xnvi/full-color-led-display-unit-board/hardware/3D预览.png

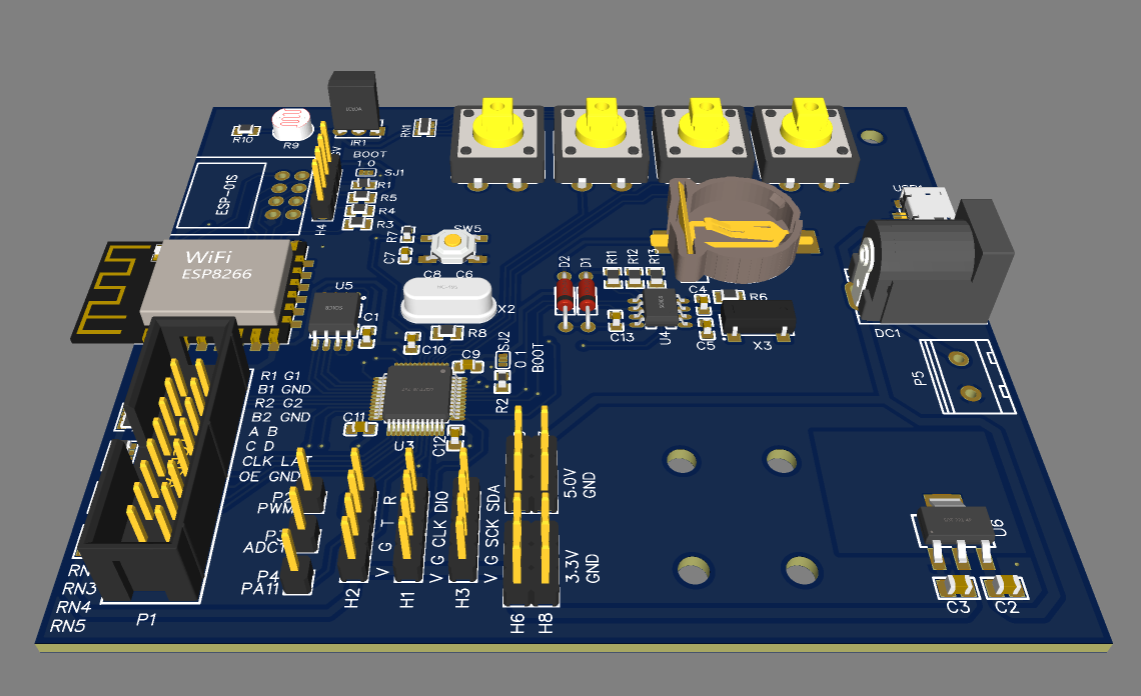
hardware/3D预览.png
