xnvi/full-color-led-display-unit-board/hardware/布线.png

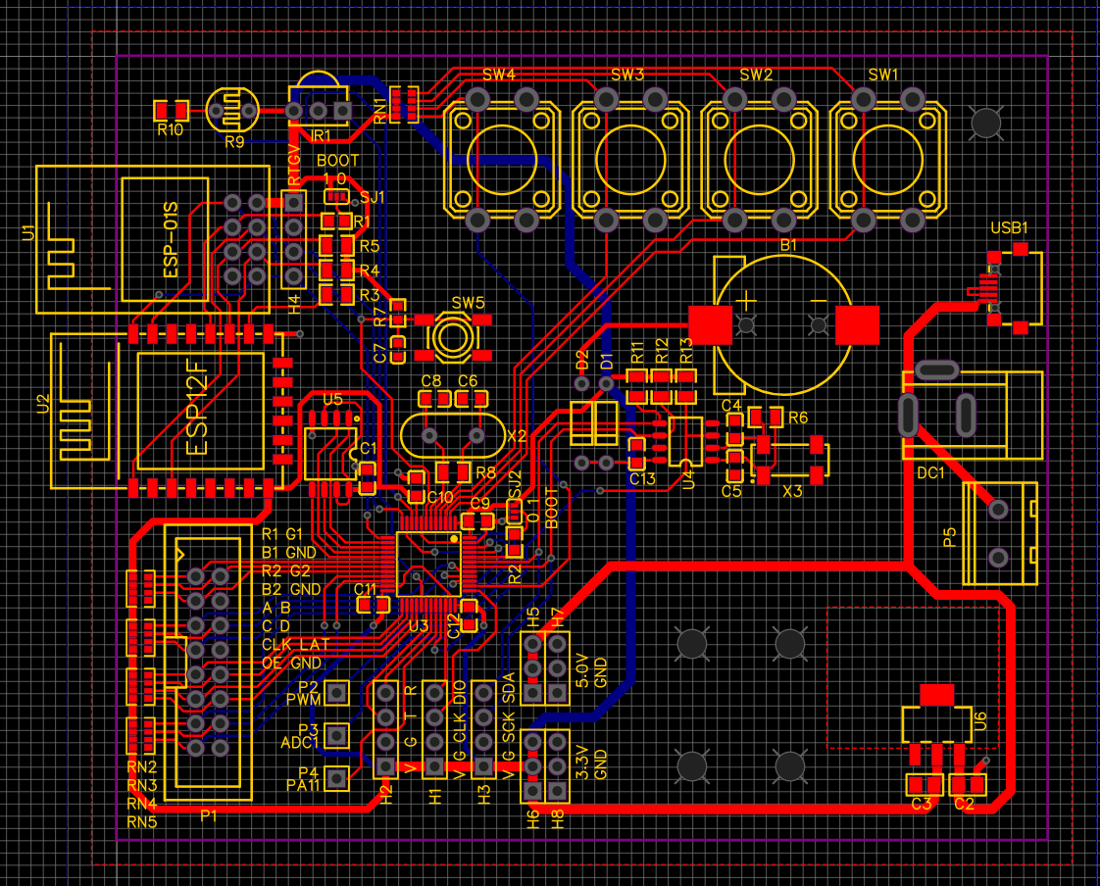
hardware/布线.png
