xnvi/full-color-led-display-unit-board/hardware/底面.png

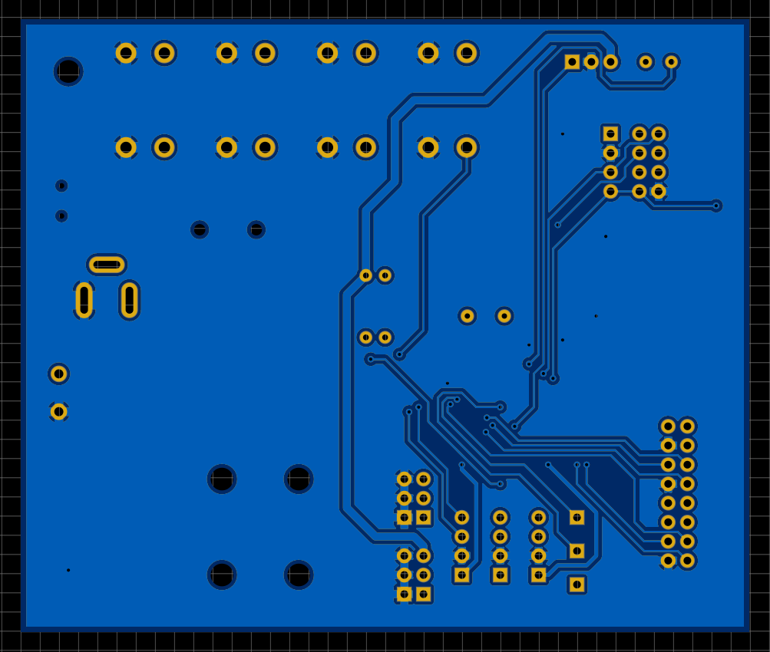
hardware/底面.png
