xnvi/full-color-led-display-unit-board/hardware/顶面.png

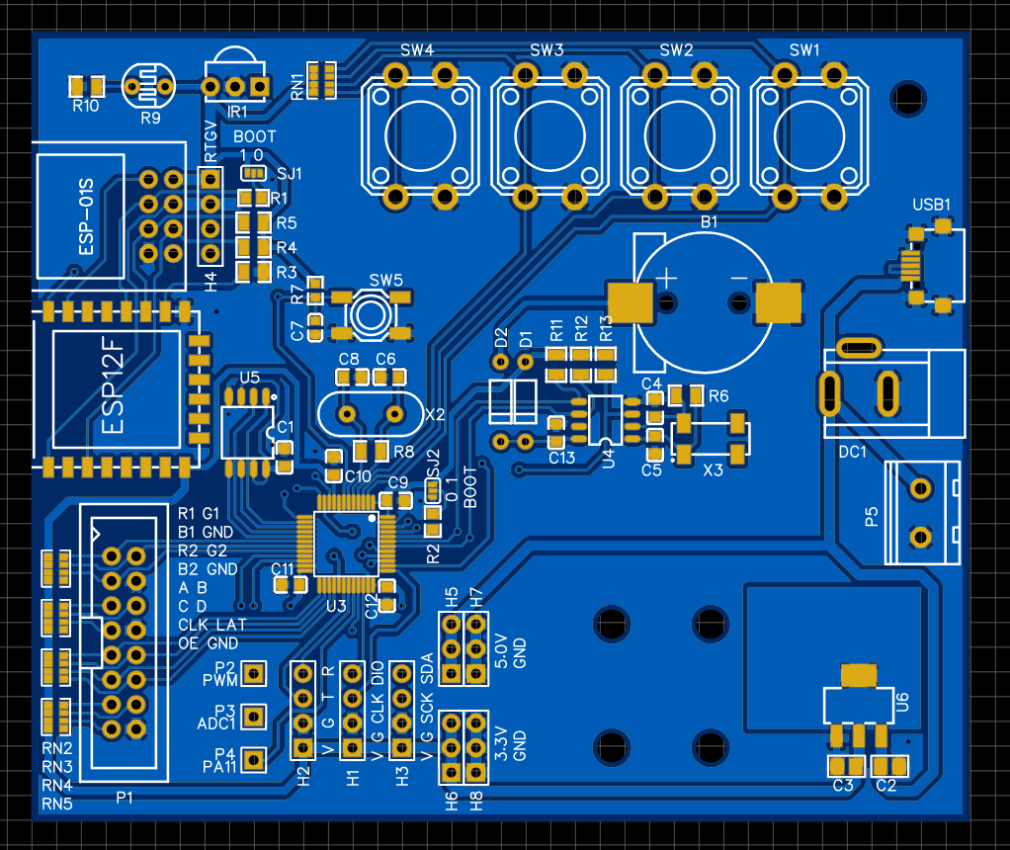
hardware/顶面.png
