xnvi/full-color-led-display-unit-board/hardware/Schematic.pdf

## F103RX与F401RX、F411RX等完全兼容

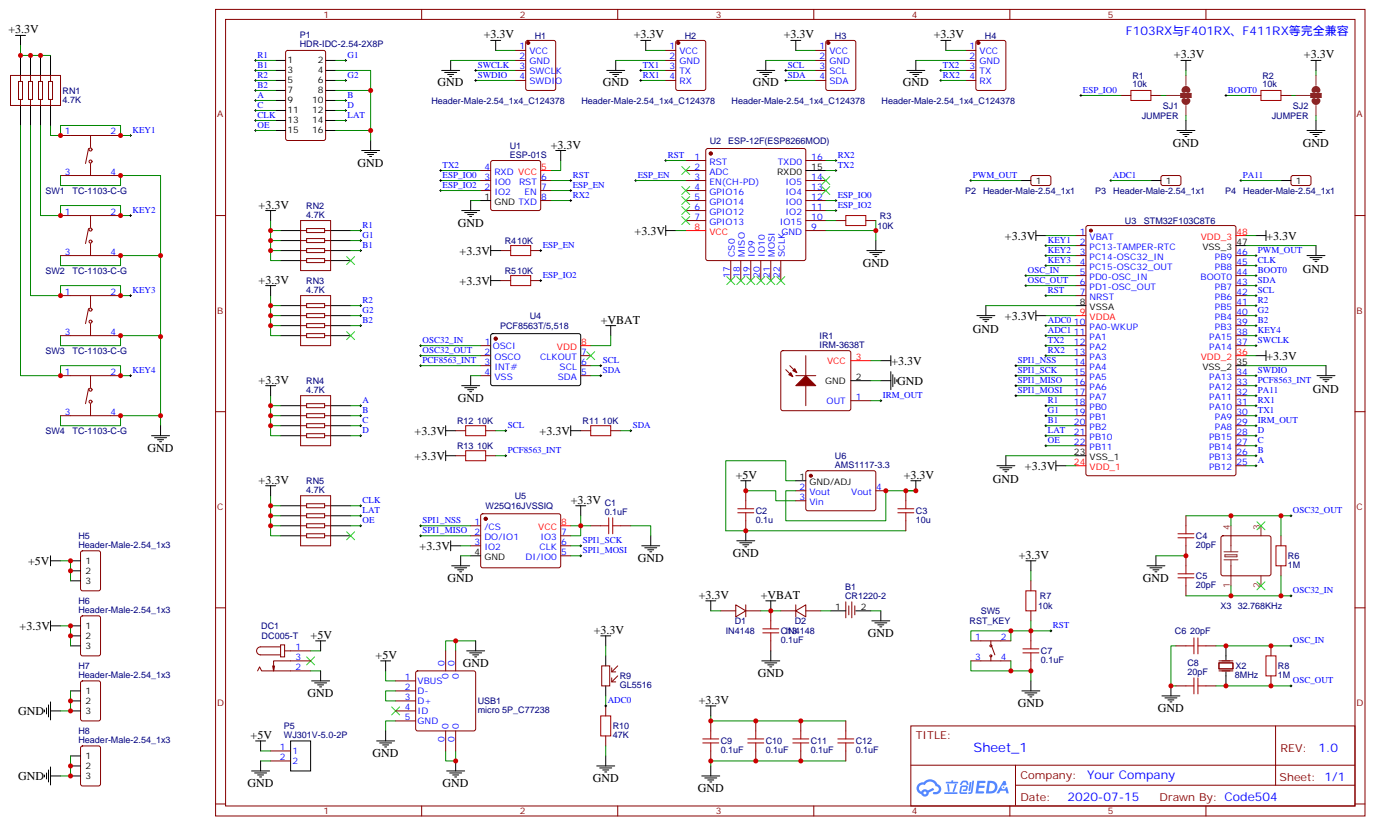
[picture p8: page 1]
