xnvi/full-color-led-display-unit-board/software/ext_lib/USMART/usmart_str.c

#include "usmart_str.h"
#include "usmart.h"		   
//////////////////////////////////////////////////////////////////////////////////	 
//本程序只供学习使用，未经作者许可，不得用于其它任何用途
//ALIENTEK STM32开发板	   
//正点原子@ALIENTEK
//技术论坛:www.openedv.com 
//版本：V3.3
//版权所有，盗版必究。
//Copyright(C) 正点原子 2011-2021
//All rights reserved
//********************************************************************************
//升级说明
//V1.4
//增加了对参数为string类型的函数的支持.适用范围大大提高.
//优化了内存占用,静态内存占用为79个字节@10个参数.动态适应数字及字符串长度
//V2.0 
//1,修改了list指令,打印函数的完整表达式.
//2,增加了id指令,打印每个函数的入口地址.
//3,修改了参数匹配,支持函数参数的调用(输入入口地址).
//4,增加了函数名长度宏定义.	
//V2.1 20110707		 
//1,增加dec,hex两个指令,用于设置参数显示进制,及执行进制转换.
//注:当dec,hex不带参数的时候,即设定显示参数进制.当后跟参数的时候,即执行进制转换.
//如:"dec 0XFF" 则会将0XFF转为255,由串口返回.
//如:"hex 100" 	则会将100转为0X64,由串口返回
//2,新增usmart_get_cmdname函数,用于获取指令名字.
//V2.2 20110726	
//1,修正了void类型参数的参数统计错误.
//2,修改数据显示格式默认为16进制.
//V2.3 20110815
//1,去掉了函数名后必须跟"("的限制.
//2,修正了字符串参数中不能有"("的bug.
//3,修改了函数默认显示参数格式的修改方式. 
//V2.4 20110905
//1,修改了usmart_get_cmdname函数,增加最大参数长度限制.避免了输入错误参数时的死机现象.
//2,增加USMART_ENTIM2_SCAN宏定义,用于配置是否使用TIM2定时执行scan函数.
//V2.5 20110930
//1,修改usmart_init函数为void usmart_init(u8 sysclk),可以根据系统频率自动设定扫描时间.(固定100ms)
//2,去掉了usmart_init函数中的uart_init函数,串口初始化必须在外部初始化,方便用户自行管理.
//V2.6 20111009
//1,增加了read_addr和write_addr两个函数.可以利用这两个函数读写内部任意地址(必须是有效地址).更加方便调试.
//2,read_addr和write_addr两个函数可以通过设置USMART_USE_WRFUNS为来使能和关闭.
//3,修改了usmart_strcmp,使其规范化.			  
//V2.7 20111024
//1,修正了返回值16进制显示时不换行的bug.
//2,增加了函数是否有返回值的判断,如果没有返回值,则不会显示.有返回值时才显示其返回值.
//V2.8 20111116
//1,修正了list等不带参数的指令发送后可能导致死机的bug.
//V2.9 20120917
//1,修改了形如：void*xxx(void)类型函数不能识别的bug。
//V3.0 20130425
//1,新增了字符串参数对转义符的支持。
//V3.1 20131120
//1,增加runtime系统指令,可以用于统计函数执行时间.
//用法:
//发送:runtime 1 ,则开启函数执行时间统计功能
//发送:runtime 0 ,则关闭函数执行时间统计功能
///runtime统计功能,必须设置:USMART_ENTIMX_SCAN 为1,才可以使用!!
//V3.2 20140828
//1,修改usmart_get_aparm函数,加入+/-符号的支持
//2,修改usmart_str2num函数,支持负数转换
//V3.3 20160506
//修正usmart_exe函数在USMART_ENTIMX_SCAN为0的时候，报错的bug
/////////////////////////////////////////////////////////////////////////////////////
  
//对比字符串str1和str2
//*str1:字符串1指针
//*str2:字符串2指针
//返回值:0，相等;1，不相等;
u8 usmart_strcmp(u8 *str1,u8 *str2)
{
	while(1)
	{
		if(*str1!=*str2)return 1;//不相等
		if(*str1=='\0')break;//对比完成了.
		str1++;
		str2++;
	}
	return 0;//两个字符串相等
}
//把str1的内容copy到str2
//*str1:字符串1指针
//*str2:字符串2指针			   
void usmart_strcopy(u8*str1,u8 *str2)
{
	while(1)
	{										   
		*str2=*str1;	//拷贝
		if(*str1=='\0')break;//拷贝完成了.
		str1++;
		str2++;
	}
}
//得到字符串的长度(字节)
//*str:字符串指针
//返回值:字符串的长度		   
u8 usmart_strlen(u8*str)
{
	u8 len=0;
	while(1)
	{							 
		if(*str=='\0')break;//拷贝完成了.
		len++;
		str++;
	}
	return len;
}
//m^n函数
//返回值:m^n次方
u32 usmart_pow(u8 m,u8 n)
{
	u32 result=1;	 
	while(n--)result*=m;    
	return result;
}	    
//把字符串转为数字
//支持16进制转换,但是16进制字母必须是大写的,且格式为以0X开头的.
//支持负数 
//*str:数字字符串指针
//*res:转换完的结果存放地址.
//返回值:0，成功转换完成.其他,错误代码.
//1,数据格式错误.2,16进制位数为0.3,起始格式错误.4,十进制位数为0.
u8 usmart_str2num(u8*str,u32 *res)
{
	u32 t;
	int tnum;
	u8 bnum=0;		//数字的位数
	u8 *p;		  
	u8 hexdec=10;	//默认为十进制数据
	u8 flag=0;		//0,没有符号标记;1,表示正数;2,表示负数.
	p=str;
	*res=0;//清零.
	while(1)
	{
		if((*p<='9'&&*p>='0')||((*str=='-'||*str=='+')&&bnum==0)||(*p<='F'&&*p>='A')||(*p=='X'&&bnum==1))//参数合法
		{
			if(*p>='A')hexdec=16;	//字符串中存在字母,为16进制格式.
			if(*str=='-'){flag=2;str+=1;}//偏移掉符号
			else if(*str=='+'){flag=1;str+=1;}//偏移掉符号
			else bnum++;			//位数增加.
		}else if(*p=='\0')break;	//碰到结束符,退出.
		else return 1;				//不全是十进制或者16进制数据.
		p++; 
	} 
	p=str;			    //重新定位到字符串开始的地址.
	if(hexdec==16)		//16进制数据
	{
		if(bnum<3)return 2;			//位数小于3，直接退出.因为0X就占了2个,如果0X后面不跟数据,则该数据非法.
		if(*p=='0' && (*(p+1)=='X'))//必须以'0X'开头.
		{
			p+=2;	//偏移到数据起始地址.
			bnum-=2;//减去偏移量	 
		}else return 3;//起始头的格式不对
	}else if(bnum==0)return 4;//位数为0，直接退出.	  
	while(1)
	{
		if(bnum)bnum--;
		if(*p<='9'&&*p>='0')t=*p-'0';	//得到数字的值
		else t=*p-'A'+10;				//得到A~F对应的值	    
		*res+=t*usmart_pow(hexdec,bnum);		   
		p++;
		if(*p=='\0')break;//数据都查完了.	
	}
	if(flag==2)//是负数?
	{	
		tnum=-*res; 
		*res=tnum;
	}
	return 0;//成功转换
}
//得到指令名
//*str:源字符串
//*cmdname:指令名
//*nlen:指令名长度		
//maxlen:最大长度(做限制,指令不可能太长的)	
//返回值:0,成功;其他,失败.	  
u8 usmart_get_cmdname(u8*str,u8*cmdname,u8 *nlen,u8 maxlen)
{
	*nlen=0;
 	while(*str!=' '&&*str!='\0') //找到空格或者结束符则认为结束了
	{
		*cmdname=*str;
		str++;
		cmdname++;
		(*nlen)++;//统计命令长度
		if(*nlen>=maxlen)return 1;//错误的指令
	}
	*cmdname='\0';//加入结束符
	return 0;//正常返回
}
//获取下一个字符（当中间有很多空格的时候，此函数直接忽略空格，找到空格之后的第一个字符）
//str:字符串指针	
//返回值:下一个字符
u8 usmart_search_nextc(u8* str)
{		   	 	
	str++;
	while(*str==' '&&str!='\0')str++;
	return *str;
} 
//从str中得到函数名
//*str:源字符串指针
//*fname:获取到的函数名字指针
//*pnum:函数的参数个数
//*rval:是否需要显示返回值(0,不需要;1,需要)
//返回值:0,成功;其他,错误代码.
u8 usmart_get_fname(u8*str,u8*fname,u8 *pnum,u8 *rval)
{
	u8 res;
	u8 fover=0;	  //括号深度
	u8 *strtemp;
	u8 offset=0;  
	u8 parmnum=0;
	u8 temp=1;
	u8 fpname[6];//void+X+'/0'
	u8 fplcnt=0; //第一个参数的长度计数器
	u8 pcnt=0;	 //参数计数器
	u8 nchar;
	//判断函数是否有返回值
	strtemp=str;
	while(*strtemp!='\0')//没有结束
	{
		if(*strtemp!=' '&&(pcnt&0X7F)<5)//最多记录5个字符
		{	
			if(pcnt==0)pcnt|=0X80;//置位最高位,标记开始接收返回值类型
			if(((pcnt&0x7f)==4)&&(*strtemp!='*'))break;//最后一个字符,必须是*
			fpname[pcnt&0x7f]=*strtemp;//记录函数的返回值类型
			pcnt++;
		}else if(pcnt==0X85)break;
		strtemp++; 
	} 
	if(pcnt)//接收完了
	{
		fpname[pcnt&0x7f]='\0';//加入结束符
		if(usmart_strcmp(fpname,"void")==0)*rval=0;//不需要返回值
		else *rval=1;							   //需要返回值
		pcnt=0;
	} 
	res=0;
	strtemp=str;
	while(*strtemp!='('&&*strtemp!='\0') //此代码找到函数名的真正起始位置
	{  
		strtemp++;
		res++;
		if(*strtemp==' '||*strtemp=='*')
		{
			nchar=usmart_search_nextc(strtemp);		//获取下一个字符
			if(nchar!='('&&nchar!='*')offset=res;	//跳过空格和*号
		}
	}	 
	strtemp=str;
	if(offset)strtemp+=offset+1;//跳到函数名开始的地方	   
	res=0;
	nchar=0;//是否正在字符串里面的标志,0，不在字符串;1，在字符串;
	while(1)
	{
		if(*strtemp==0)
		{
			res=USMART_FUNCERR;//函数错误
			break;
		}else if(*strtemp=='('&&nchar==0)fover++;//括号深度增加一级	 
		else if(*strtemp==')'&&nchar==0)
		{
			if(fover)fover--;
			else res=USMART_FUNCERR;//错误结束,没收到'('
			if(fover==0)break;//到末尾了,退出	    
		}else if(*strtemp=='"')nchar=!nchar;

		if(fover==0)//函数名还没接收完
		{
			if(*strtemp!=' ')//空格不属于函数名
			{
				*fname=*strtemp;//得到函数名
				fname++;
			}
		}else //已经接受完了函数名了.
		{
			if(*strtemp==',')
			{
				temp=1;		//使能增加一个参数
				pcnt++;	
			}else if(*strtemp!=' '&&*strtemp!='(')
			{
				if(pcnt==0&&fplcnt<5)		//当第一个参数来时,为了避免统计void类型的参数,必须做判断.
				{
					fpname[fplcnt]=*strtemp;//记录参数特征.
					fplcnt++;
				}
				temp++;	//得到有效参数(非空格)
			}
			if(fover==1&&temp==2)
			{
				temp++;		//防止重复增加
				parmnum++; 	//参数增加一个
			}
		}
		strtemp++; 			
	}   
	if(parmnum==1)//只有1个参数.
	{
		fpname[fplcnt]='\0';//加入结束符
		if(usmart_strcmp(fpname,"void")==0)parmnum=0;//参数为void,表示没有参数.
	}
	*pnum=parmnum;	//记录参数个数
	*fname='\0';	//加入结束符
	return res;		//返回执行结果
}


//从str中得到一个函数的参数
//*str:源字符串指针
//*fparm:参数字符串指针
//*ptype:参数类型 0，数字;1，字符串;0XFF，参数错误
//返回值:0,已经无参数了;其他,下一个参数的偏移量.
u8 usmart_get_aparm(u8 *str,u8 *fparm,u8 *ptype)
{
	u8 i=0;
	u8 enout=0;
	u8 type=0;//默认是数字
	u8 string=0; //标记str是否正在读
	while(1)
	{		    
		if(*str==','&& string==0)enout=1;			//暂缓立即退出,目的是寻找下一个参数的起始地址
		if((*str==')'||*str=='\0')&&string==0)break;//立即退出标识符
		if(type==0)//默认是数字的
		{
			if((*str>='0' && *str<='9')||*str=='-'||*str=='+'||(*str>='a' && *str<='f')||(*str>='A' && *str<='F')||*str=='X'||*str=='x')//数字串检测
			{
				if(enout)break;					//找到了下一个参数,直接退出.
				if(*str>='a')*fparm=*str-0X20;	//小写转换为大写
				else *fparm=*str;		   		//小写或者数字保持不变
				fparm++;
			}else if(*str=='"')//找到字符串的开始标志
			{
				if(enout)break;//找到,后才找到",认为结束了.
				type=1;
				string=1;//登记STRING 正在读了
			}else if(*str!=' '&&*str!=',')//发现非法字符,参数错误
			{
				type=0XFF;
				break;
			}
		}else//string类
		{ 
			if(*str=='"')string=0;
			if(enout)break;			//找到了下一个参数,直接退出.
			if(string)				//字符串正在读
			{	
				if(*str=='\\')		//遇到转义符(不复制转义符)
				{ 
					str++;			//偏移到转义符后面的字符,不管什么字符,直接COPY
					i++;
				}					
				*fparm=*str;		//小写或者数字保持不变
				fparm++;
			}	
		}
		i++;//偏移量增加
		str++;
	}
	*fparm='\0';	//加入结束符
	*ptype=type;	//返回参数类型
	return i;		//返回参数长度
}
//得到指定参数的起始地址
//num:第num个参数,范围0~9.
//返回值:该参数的起始地址
u8 usmart_get_parmpos(u8 num)
{
	u8 temp=0;
	u8 i;
	for(i=0;i<num;i++)temp+=usmart_dev.plentbl[i];
	return temp;
}
//从str中得到函数参数
//str:源字符串;
//parn:参数的多少.0表示无参数 void类型
//返回值:0,成功;其他,错误代码.
u8 usmart_get_fparam(u8*str,u8 *parn)
{	
	u8 i,type;  
	u32 res;
	u8 n=0;
	u8 len;
	u8 tstr[PARM_LEN+1];//字节长度的缓存,最多可以存放PARM_LEN个字符的字符串
	for(i=0;i<MAX_PARM;i++)usmart_dev.plentbl[i]=0;//清空参数长度表
	while(*str!='(')//偏移到参数开始的地方
	{
		str++;											    
		if(*str=='\0')return USMART_FUNCERR;//遇到结束符了
	}
	str++;//偏移到"("之后的第一个字节
	while(1)
	{
		i=usmart_get_aparm(str,tstr,&type);	//得到第一个参数  
		str+=i;								//偏移
		switch(type)
		{
			case 0:	//数字
				if(tstr[0]!='\0')				//接收到的参数有效
				{					    
					i=usmart_str2num(tstr,&res);	//记录该参数	 
					if(i)return USMART_PARMERR;		//参数错误.
					*(u32*)(usmart_dev.parm+usmart_get_parmpos(n))=res;//记录转换成功的结果.
					usmart_dev.parmtype&=~(1<<n);	//标记数字
					usmart_dev.plentbl[n]=4;		//该参数的长度为4  
					n++;							//参数增加  
					if(n>MAX_PARM)return USMART_PARMOVER;//参数太多
				}
				break;
			case 1://字符串	 	
				len=usmart_strlen(tstr)+1;	//包含了结束符'\0'
				usmart_strcopy(tstr,&usmart_dev.parm[usmart_get_parmpos(n)]);//拷贝tstr数据到usmart_dev.parm[n]
				usmart_dev.parmtype|=1<<n;	//标记字符串 
				usmart_dev.plentbl[n]=len;	//该参数的长度为len  
				n++;
				if(n>MAX_PARM)return USMART_PARMOVER;//参数太多
				break;
			case 0XFF://错误
				return USMART_PARMERR;//参数错误	  
		}
		if(*str==')'||*str=='\0')break;//查到结束标志了.
	}
	*parn=n;	//记录参数的个数
	return USMART_OK;//正确得到了参数
}
