xnvi/full-color-led-display-unit-board/software/user_code/zh_cn12.c

/*
字库取模方式
目前用的 PCtoLCD2002
阴码 逆向（低位在前） 列行式
*/

#include <stdint.h>
#include "font_lite.h"

// !!!! 二分查找要求所有汉字索引必须排序 !!!!
const font12_struct font12_table[] = 
{
	// {"测", 0, {0x22,0x44,0xFE,0x02,0xFA,0x02,0xFE,0x00,0xFC,0x00,0xFF,0x00,0x04,0x02,0x09,0x04,0x03,0x04,0x09,0x00,0x01,0x08,0x0F,0x00},},
	// {"试", 0, {0x11,0xF2,0x00,0x00,0x24,0xE4,0x24,0x04,0xFF,0x04,0x05,0x00,0x00,0x0F,0x04,0x00,0x04,0x07,0x02,0x00,0x03,0x04,0x0E,0x00},},
	// {"文", 0, {0x04,0x04,0x1C,0x64,0x85,0x06,0x84,0x64,0x1C,0x04,0x04,0x00,0x08,0x08,0x04,0x04,0x02,0x01,0x02,0x04,0x04,0x08,0x08,0x00},},
	// {"中", 0, {0x00,0xF8,0x88,0x88,0x88,0xFF,0x88,0x88,0x88,0xF8,0x00,0x00,0x00,0x01,0x00,0x00,0x00,0x0F,0x00,0x00,0x00,0x01,0x00,0x00},},

	{"八", 0, {0x00,0x00,0x00,0xFE,0x00,0x00,0x00,0x7F,0x80,0x00,0x00,0x00,0x08,0x04,0x03,0x00,0x00,0x00,0x00,0x00,0x01,0x06,0x08,0x00},},
	{"白", 0, {0x00,0xFC,0x44,0x46,0x45,0x44,0x44,0x44,0x44,0xFC,0x00,0x00,0x00,0x0F,0x04,0x04,0x04,0x04,0x04,0x04,0x04,0x0F,0x00,0x00},},
	{"保", 0, {0x20,0x10,0xFC,0x03,0x40,0x5E,0x52,0xF2,0x52,0x5E,0x40,0x00,0x00,0x00,0x0F,0x00,0x04,0x02,0x01,0x0F,0x01,0x02,0x04,0x00},},
	{"本", 0, {0x04,0x04,0x84,0x64,0x14,0xFF,0x14,0x64,0x84,0x04,0x04,0x00,0x02,0x01,0x02,0x02,0x02,0x0F,0x02,0x02,0x02,0x01,0x02,0x00},},
	{"变", 0, {0x12,0x4A,0xC2,0x5E,0x42,0x43,0x42,0x5E,0xC2,0x0A,0x12,0x00,0x08,0x08,0x04,0x05,0x02,0x02,0x02,0x05,0x04,0x08,0x08,0x00},},
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
	{"能", 0, {0x04,0xF6,0x55,0x54,0xF6,0x00,0xCF,0x14,0x12,0x91,0x18,0x00,0x00,0x0F,0x01,0x09,0x0F,0x00,0x07,0x0A,0x09,0x08,0x0E,0x00},},
	{"年", 0, {0x10,0x08,0xE7,0x24,0x24,0x24,0xFC,0x24,0x24,0x24,0x04,0x00,0x01,0x01,0x01,0x01,0x01,0x01,0x0F,0x01,0x01,0x01,0x01,0x00},},
	{"女", 0, {0x08,0x08,0x48,0xB8,0x8F,0x08,0x88,0x48,0x38,0x08,0x08,0x00,0x08,0x08,0x04,0x04,0x02,0x01,0x02,0x02,0x04,0x08,0x00,0x00},},
	{"屏", 0, {0x00,0xFF,0x05,0x25,0x2D,0xF5,0x25,0x25,0xF5,0x2D,0x27,0x00,0x08,0x07,0x01,0x09,0x05,0x03,0x01,0x01,0x0F,0x01,0x01,0x00},},
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
};
