xnvi/full-color-led-display-unit-board/software/user_code/ascii16.h

#ifndef _ASCII16_VER_H
#define _ASCII16_VER_H

//95个可显示ASCII字符列表
//16x8 点阵
//从0算起，32到126为可显示字符，使用时减去32(0x20)即可
//取模方式：阴码 逆向（低位在前） 列行式
const unsigned char ASCII16[1520]={
0x00,0x00,0x00,0x00,0x00,0x00,0x00,0x00,0x00,0x00,0x00,0x00,0x00,0x00,0x00,0x00, /*空格,0*/
0x00,0x00,0x00,0xF8,0x00,0x00,0x00,0x00,0x00,0x00,0x00,0x33,0x30,0x00,0x00,0x00, /*!,1*/
0x00,0x10,0x0C,0x06,0x10,0x0C,0x06,0x00,0x00,0x00,0x00,0x00,0x00,0x00,0x00,0x00, /*",2*/
0x00,0x40,0xF8,0x40,0x40,0xF8,0x40,0x00,0x00,0x04,0x3F,0x04,0x04,0x3F,0x04,0x00, /*#,3*/
0x00,0x70,0x88,0xFC,0x08,0x30,0x00,0x00,0x00,0x18,0x20,0xFF,0x21,0x1E,0x00,0x00, /*$,4*/
0x30,0x48,0x30,0x80,0x60,0x18,0x00,0x00,0x00,0x30,0x0C,0x03,0x18,0x24,0x18,0x00, /*%,5*/
0x00,0xF0,0x08,0x88,0x70,0x00,0x00,0x00,0x1E,0x21,0x23,0x24,0x19,0x27,0x21,0x10, /*&,6*/
0x10,0x16,0x0E,0x00,0x00,0x00,0x00,0x00,0x00,0x00,0x00,0x00,0x00,0x00,0x00,0x00, /*',7*/
0x00,0x00,0x00,0xE0,0x18,0x04,0x02,0x00,0x00,0x00,0x00,0x07,0x18,0x20,0x40,0x00, /*(,8*/
0x00,0x02,0x04,0x18,0xE0,0x00,0x00,0x00,0x00,0x40,0x20,0x18,0x07,0x00,0x00,0x00, /*),9*/
0x40,0x40,0x80,0xF0,0x80,0x40,0x40,0x00,0x02,0x02,0x01,0x0F,0x01,0x02,0x02,0x00, /**,10*/
0x00,0x00,0x00,0xF0,0x00,0x00,0x00,0x00,0x01,0x01,0x01,0x1F,0x01,0x01,0x01,0x00, /*+,11*/
0x00,0x00,0x00,0x00,0x00,0x00,0x00,0x00,0x80,0xB0,0x70,0x00,0x00,0x00,0x00,0x00, /*,,12*/
0x00,0x00,0x00,0x00,0x00,0x00,0x00,0x00,0x00,0x01,0x01,0x01,0x01,0x01,0x01,0x01, /*-,13*/
0x00,0x00,0x00,0x00,0x00,0x00,0x00,0x00,0x00,0x30,0x30,0x00,0x00,0x00,0x00,0x00, /*.,14*/
0x00,0x00,0x00,0x00,0x80,0x60,0x18,0x04,0x00,0x60,0x18,0x06,0x01,0x00,0x00,0x00, /*/,15*/
0x00,0xE0,0x10,0x08,0x08,0x10,0xE0,0x00,0x00,0x0F,0x10,0x20,0x20,0x10,0x0F,0x00, /*0,16*/
0x00,0x00,0x08,0xFC,0x00,0x00,0x00,0x00,0x00,0x00,0x20,0x3F,0x20,0x00,0x00,0x00, /*1,17*/
0x00,0x70,0x08,0x08,0x08,0x88,0x70,0x00,0x00,0x30,0x28,0x24,0x22,0x21,0x30,0x00, /*2,18*/
0x00,0x30,0x08,0x88,0x88,0x48,0x30,0x00,0x00,0x18,0x20,0x20,0x20,0x11,0x0E,0x00, /*3,19*/
0x00,0x00,0xC0,0x30,0x08,0xFC,0x00,0x00,0x00,0x07,0x04,0x04,0x24,0x3F,0x24,0x00, /*4,20*/
0x00,0xF8,0x88,0x88,0x88,0x88,0x08,0x00,0x00,0x18,0x20,0x20,0x20,0x20,0x1F,0x00, /*5,21*/
0x00,0xF0,0x08,0x88,0x88,0x88,0x30,0x00,0x00,0x1F,0x21,0x20,0x20,0x20,0x1F,0x00, /*6,22*/
0x00,0x38,0x08,0x08,0xC8,0x38,0x08,0x00,0x00,0x00,0x00,0x3F,0x00,0x00,0x00,0x00, /*7,23*/
0x00,0x70,0x88,0x08,0x08,0x88,0x70,0x00,0x00,0x1C,0x22,0x21,0x21,0x22,0x1C,0x00, /*8,24*/
0x00,0xF0,0x08,0x08,0x08,0x08,0xF0,0x00,0x00,0x19,0x22,0x22,0x22,0x22,0x1F,0x00, /*9,25*/
0x00,0x00,0x00,0xC0,0xC0,0x00,0x00,0x00,0x00,0x00,0x00,0x30,0x30,0x00,0x00,0x00, /*:,26*/
0x00,0x00,0x00,0x80,0x00,0x00,0x00,0x00,0x00,0x00,0x80,0x60,0x00,0x00,0x00,0x00, /*;,27*/
0x00,0x00,0x80,0x40,0x20,0x10,0x08,0x00,0x00,0x01,0x02,0x04,0x08,0x10,0x20,0x00, /*<,28*/
0x40,0x40,0x40,0x40,0x40,0x40,0x40,0x00,0x04,0x04,0x04,0x04,0x04,0x04,0x04,0x00, /*=,29*/
0x00,0x08,0x10,0x20,0x40,0x80,0x00,0x00,0x00,0x20,0x10,0x08,0x04,0x02,0x01,0x00, /*>,30*/
0x00,0x70,0x08,0x08,0x08,0x88,0x70,0x00,0x00,0x00,0x00,0x00,0x2E,0x01,0x00,0x00, /*?,31*/
0xC0,0x30,0xC8,0x28,0xE8,0x10,0xE0,0x00,0x07,0x18,0x27,0x24,0x23,0x14,0x0B,0x00, /*@,32*/
0x00,0x00,0xC0,0x38,0xE0,0x00,0x00,0x00,0x20,0x3C,0x23,0x02,0x02,0x27,0x38,0x20, /*A,33*/
0x08,0xF8,0x88,0x88,0x88,0x70,0x00,0x00,0x20,0x3F,0x20,0x20,0x20,0x11,0x0E,0x00, /*B,34*/
0xC0,0x30,0x08,0x08,0x08,0x08,0x38,0x00,0x07,0x18,0x20,0x20,0x20,0x10,0x08,0x00, /*C,35*/
0x08,0xF8,0x08,0x08,0x08,0x10,0xE0,0x00,0x20,0x3F,0x20,0x20,0x20,0x10,0x0F,0x00, /*D,36*/
0x08,0xF8,0x88,0x88,0x88,0xC8,0x18,0x00,0x20,0x3F,0x20,0x20,0x20,0x21,0x30,0x00, /*E,37*/
0x08,0xF8,0x88,0x88,0x88,0xC8,0x18,0x00,0x20,0x3F,0x20,0x00,0x00,0x01,0x00,0x00, /*F,38*/
0xC0,0x30,0x08,0x08,0x08,0x38,0x00,0x00,0x07,0x18,0x20,0x20,0x22,0x1E,0x02,0x00, /*G,39*/
0x08,0xF8,0x08,0x00,0x00,0x08,0xF8,0x08,0x20,0x3F,0x21,0x01,0x01,0x21,0x3F,0x20, /*H,40*/
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
};

#endif
