xnvi/full-color-led-display-unit-board/software/ext_lib/sfud/port/sfud_port.c

/*
 * This file is part of the Serial Flash Universal Driver Library.
 *
 * Copyright (c) 2016-2018, Armink, <armink.ztl@gmail.com>
 *
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
 * Function: Portable interface for each platform.
 * Created on: 2016-04-23
 */

#include <sfud.h>
#include <stdarg.h>

#include "delay.h"
#include "spi.h"
#include "stm32f1xx_ll_gpio.h"

static char log_buf[256];

void sfud_log_debug(const char *file, const long line, const char *format, ...);


#define SPI1_CS_PORT GPIOA
#define SPI1_CS_PIN  LL_GPIO_PIN_4

static void spi_lock(const sfud_spi *spi) {
    // __disable_irq();
}

static void spi_unlock(const sfud_spi *spi) {
    // __enable_irq();
}

static void delay_100us(void)
{
	delay_us(100);
}

/**
 * SPI write data then read data
 */
static sfud_err spi_write_read(const sfud_spi *spi, const uint8_t *write_buf, size_t write_size, uint8_t *read_buf,
        size_t read_size) {
    sfud_err result = SFUD_SUCCESS;
    uint8_t send_data, read_data;

    /**
     * add your spi write and read code
     */

#if 1
    // spi_user_data_t spi_dev = (spi_user_data_t) spi->user_data;

    if (write_size) {
        SFUD_ASSERT(write_buf);
    }
    if (read_size) {
        SFUD_ASSERT(read_buf);
    }

    // GPIO_ResetBits(spi_dev->cs_gpiox, spi_dev->cs_gpio_pin);
	LL_GPIO_ResetOutputPin(SPI1_CS_PORT, SPI1_CS_PIN);
    /* 开始读写数据 */
    // for (size_t i = 0, retry_times; i < write_size + read_size; i++) {
    for (size_t i = 0; i < write_size + read_size; i++) {
        // 先写缓冲区中的数据到 SPI 总线，数据写完后，再写 dummy(0xFF) 到 SPI 总线
        if (i < write_size) {
            send_data = *write_buf++;
        } else {
            send_data = SFUD_DUMMY_DATA;
        }

		#if 0
        // 发送数据
        retry_times = 1000;
        while (SPI_I2S_GetFlagStatus(spi_dev->spix, SPI_I2S_FLAG_TXE) == RESET) {
            SFUD_RETRY_PROCESS(NULL, retry_times, result);
        }
        if (result != SFUD_SUCCESS) {
            goto exit;
        }
        SPI_I2S_SendData(spi_dev->spix, send_data);
        // 接收数据
        retry_times = 1000;
        while (SPI_I2S_GetFlagStatus(spi_dev->spix, SPI_I2S_FLAG_RXNE) == RESET) {
            SFUD_RETRY_PROCESS(NULL, retry_times, result);
        }
        if (result != SFUD_SUCCESS) {
            goto exit;
        }
        read_data = SPI_I2S_ReceiveData(spi_dev->spix);
		#endif

		read_data = SPI1_ReadWriteByte(send_data);

        // 写缓冲区中的数据发完后，再读取 SPI 总线中的数据到读缓冲区
        if (i >= write_size) {
            *read_buf++ = read_data;
        }
    }

// exit:
    // GPIO_SetBits(spi_dev->cs_gpiox, spi_dev->cs_gpio_pin);
	LL_GPIO_SetOutputPin(SPI1_CS_PORT, SPI1_CS_PIN);
#endif

    return result;
}

#ifdef SFUD_USING_QSPI
/**
 * read flash data by QSPI
 */
static sfud_err qspi_read(const struct __sfud_spi *spi, uint32_t addr, sfud_qspi_read_cmd_format *qspi_read_cmd_format,
        uint8_t *read_buf, size_t read_size) {
    sfud_err result = SFUD_SUCCESS;

    /**
     * add your qspi read flash data code
     */

    return result;
}
#endif /* SFUD_USING_QSPI */

sfud_err sfud_spi_port_init(sfud_flash *flash) {
    sfud_err result = SFUD_SUCCESS;

    /**
     * add your port spi bus and device object initialize code like this:
     * 1. rcc initialize
     * 2. gpio initialize
     * 3. spi device initialize
     * 4. flash->spi and flash->retry item initialize
     *    flash->spi.wr = spi_write_read; //Required
     *    flash->spi.qspi_read = qspi_read; //Required when QSPI mode enable
     *    flash->spi.lock = spi_lock;
     *    flash->spi.unlock = spi_unlock;
     *    flash->spi.user_data = &spix;
     *    flash->retry.delay = null;
     *    flash->retry.times = 10000; //Required
     */

	switch (flash->index)
	{
		case SFUD_GD25Q16_DEVICE_INDEX:
			/* RCC 初始化 */
			// rcc_configuration(&spi1);
			/* GPIO 初始化 */
			// gpio_configuration(&spi1);
			/* SPI 外设初始化 */
			// spi_configuration(&spi1);
			/* 同步 Flash 移植所需的接口及数据 */
			flash->spi.wr = spi_write_read;
			flash->spi.lock = spi_lock;
			flash->spi.unlock = spi_unlock;
			flash->spi.user_data = NULL;
			/* about 100 microsecond delay */
			flash->retry.delay = delay_100us;
			/* adout 10 seconds timeout */
			flash->retry.times = 10 * 10000;

			break;
		default:
			break;
    }

    return result;
}

/**
 * This function is print debug info.
 *
 * @param file the file which has call this function
 * @param line the line number which has call this function
 * @param format output format
 * @param ... args
 */
void sfud_log_debug(const char *file, const long line, const char *format, ...) {
    va_list args;

    /* args point to the first variable parameter */
    va_start(args, format);
    printf("[SFUD](%s:%ld) ", file, line);
    /* must use vprintf to print */
    vsnprintf(log_buf, sizeof(log_buf), format, args);
    printf("%s\n", log_buf);
    va_end(args);
}

/**
 * This function is print routine info.
 *
 * @param format output format
 * @param ... args
 */
void sfud_log_info(const char *format, ...) {
    va_list args;

    /* args point to the first variable parameter */
    va_start(args, format);
    printf("[SFUD]");
    /* must use vprintf to print */
    vsnprintf(log_buf, sizeof(log_buf), format, args);
    printf("%s\n", log_buf);
    va_end(args);
}
