xnvi/full-color-led-display-unit-board/software/user_code/ascii12.h

#ifndef _ASCII12_H
#define _ASCII12_H

const unsigned char ASCII12 [1140] = {
0x00,0x00,0x00,0x00,0x00,0x00,0x00,0x00,0x00,0x00,0x00,0x00,
0x00,0x00,0xfe,0x00,0x00,0x00,0x00,0x00,0x05,0x00,0x00,0x00,
0x00,0x06,0x00,0x06,0x00,0x00,0x00,0x00,0x00,0x00,0x00,0x00,
0x88,0xfe,0x88,0xfe,0x88,0x00,0x00,0x07,0x00,0x07,0x00,0x00,
0x18,0x24,0xfe,0x44,0x88,0x00,0x01,0x02,0x07,0x02,0x01,0x00,
0x0c,0x92,0x6c,0x98,0x06,0x00,0x06,0x01,0x03,0x04,0x03,0x00,
0xdc,0x22,0x62,0x9c,0x40,0x00,0x03,0x04,0x04,0x03,0x04,0x00,
0x00,0x00,0x06,0x00,0x00,0x00,0x00,0x00,0x00,0x00,0x00,0x00,
0x00,0xf0,0x0c,0x02,0x00,0x00,0x00,0x00,0x03,0x04,0x00,0x00,
0x00,0x02,0x0c,0xf0,0x00,0x00,0x00,0x04,0x03,0x00,0x00,0x00,
0x88,0x50,0xfc,0x50,0x88,0x00,0x00,0x00,0x01,0x00,0x00,0x00,
0x20,0x20,0xf8,0x20,0x20,0x00,0x00,0x00,0x00,0x00,0x00,0x00,
0x00,0x00,0x00,0x00,0x00,0x00,0x00,0x05,0x03,0x00,0x00,0x00,
0x20,0x20,0x20,0x20,0x20,0x00,0x00,0x00,0x00,0x00,0x00,0x00,
0x00,0x00,0x00,0x00,0x00,0x00,0x00,0x06,0x06,0x00,0x00,0x00,
0x00,0x80,0x60,0x18,0x06,0x00,0x06,0x01,0x00,0x00,0x00,0x00,
0xfc,0x82,0x42,0x22,0xfc,0x00,0x03,0x04,0x04,0x04,0x03,0x00,
0x00,0x04,0xfe,0x00,0x00,0x00,0x00,0x04,0x07,0x04,0x00,0x00,
0x0c,0x82,0x42,0x22,0x1c,0x00,0x07,0x04,0x04,0x04,0x04,0x00,
0x0c,0x02,0x22,0x22,0xdc,0x00,0x03,0x04,0x04,0x04,0x03,0x00,
0xc0,0x30,0x0c,0xfe,0x00,0x00,0x01,0x01,0x01,0x07,0x01,0x00,
0x3e,0x22,0x22,0x22,0xc2,0x00,0x02,0x04,0x04,0x04,0x03,0x00,
0xfc,0x22,0x22,0x22,0xc4,0x00,0x03,0x04,0x04,0x04,0x03,0x00,
0x06,0x02,0x82,0x62,0x1e,0x00,0x00,0x00,0x07,0x00,0x00,0x00,
0xdc,0x22,0x22,0x22,0xdc,0x00,0x03,0x04,0x04,0x04,0x03,0x00,
0x3c,0x42,0x42,0x42,0xfc,0x00,0x02,0x04,0x04,0x04,0x03,0x00,
0x00,0x00,0x18,0x00,0x00,0x00,0x00,0x00,0x03,0x00,0x00,0x00,
0x00,0x00,0x18,0x00,0x00,0x00,0x00,0x04,0x03,0x00,0x00,0x00,
0x40,0xa0,0x10,0x08,0x04,0x00,0x00,0x00,0x01,0x02,0x04,0x00,
0x20,0x20,0x20,0x20,0x20,0x00,0x01,0x01,0x01,0x01,0x01,0x00,
0x04,0x08,0x10,0xa0,0x40,0x00,0x04,0x02,0x01,0x00,0x00,0x00,
0x0c,0x02,0xc2,0x22,0x1c,0x00,0x00,0x00,0x05,0x00,0x00,0x00,
0xfc,0x02,0xf2,0x0a,0xfc,0x00,0x03,0x04,0x05,0x05,0x01,0x00,
0x80,0xf0,0x8e,0xf0,0x80,0x00,0x07,0x00,0x00,0x00,0x07,0x00,
0xfe,0x22,0x22,0x22,0xdc,0x00,0x07,0x04,0x04,0x04,0x03,0x00,
0xfc,0x02,0x02,0x02,0x0c,0x00,0x03,0x04,0x04,0x04,0x03,0x00,
0xfe,0x02,0x02,0x02,0xfc,0x00,0x07,0x04,0x04,0x04,0x03,0x00,
0xfe,0x22,0x22,0x22,0x02,0x00,0x07,0x04,0x04,0x04,0x04,0x00,
0xfe,0x22,0x22,0x22,0x02,0x00,0x07,0x00,0x00,0x00,0x00,0x00,
0xfc,0x02,0x42,0x42,0xcc,0x00,0x03,0x04,0x04,0x02,0x07,0x00,
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
};

#endif
