xnvi/full-color-led-display-unit-board/software/ext_lib/USMART/usmart_config.c

#include "usmart.h"
#include "usmart_str.h"
////////////////////////////用户配置区///////////////////////////////////////////////
//这下面要包含所用到的函数所申明的头文件(用户自己添加) 
#include "stm32f1xx_hal.h"
#include "utils.h"

//函数名列表初始化(用户自己添加)
//用户直接在这里输入要执行的函数名及其查找串
struct _m_usmart_nametab usmart_nametab[]=
{
#if USMART_USE_WRFUNS==1 	//如果使能了读写操作
	(void*)read_addr, "u32 read_addr(u32 addr)",
	(void*)write_addr, "void write_addr(u32 addr,u32 val)",
#endif
	(void*)HAL_Delay, "void HAL_Delay(__IO uint32_t Delay)",
	(void*)erase_spi, "void erase_spi(void)",
	(void*)write_spi, "void write_spi(void)",
	// (void*)report, "void report(u32 cfg)",
	// (void*) PwmT4C1Set, "void PwmT4C1Set(unsigned int val)",
	// (void*) PwmT4C2Set, "void PwmT4C1Set(unsigned int val)",
};
				  
///////////////////////////////////END///////////////////////////////////////////////
/////////////////////////////////////////////////////////////////////////////////////
//函数控制管理器初始化
//得到各个受控函数的名字
//得到函数总数量
struct _m_usmart_dev usmart_dev=
{
	usmart_nametab,
	usmart_init,
	usmart_cmd_rec,
	usmart_exe,
	usmart_scan,
	sizeof(usmart_nametab)/sizeof(struct _m_usmart_nametab),//函数数量
	0,	  	//参数数量
	0,	 	//函数ID
	1,		//参数显示类型,0,10进制;1,16进制
	0,		//参数类型.bitx:,0,数字;1,字符串	    
	0,	  	//每个参数的长度暂存表,需要MAX_PARM个0初始化
	0,		//函数的参数,需要PARM_LEN个0初始化
};   
