xnvi/full-color-led-display-unit-board/(commit log)

2022-03-01 添加硬件
2022-03-15 添加CubeMX工程
2022-03-19 添加第三方库
2022-04-21 feat: 添加部分外设驱动
2022-04-30 feat: 添加一些外设驱动等
2022-05-01 feat: 添加字体显示相关功能
2022-05-01 feat: 完善串口相关功能
2022-05-01 feat: 添加图像相关代码
2022-05-01 feat: 添加音乐频谱相关代码
2022-05-01 feat: 完善其他功能
2022-05-01 feat: 完善工程
2022-05-03 feat: 更新文档
