xnvi/full-color-led-display-unit-board/(notices)

Notices in the files:
software/Inc/main.h:
Copyright (c) 2022 STMicroelectronics.
All rights reserved.
This software is licensed under terms that can be found in the LICENSE file
software/ext_lib/USMART/usmart.c:
Copyright(C) ÕýµãÔ­×Ó 2011-2021
